HexabitzPlatform/H2AR3x-Hardware/README.md

# H2AR3x-Hardware
Hexabitz AC Current and Voltage Sensor Module Hardware Design
