HexabitzPlatform/H2AR3x-Hardware/H2AR32/Release/BOM/H2AR32.xlsx

 |  | www.hexabitz.com info@hexabitz.com |  | Bill Of Materials
Customer | Hexabitz | Revision | 2
Project | Hexabitz Modules | Date | 2023-09-26
Board | AC Current and Voltage Sensor Module (H2AR32) | Notes
Designator | Description | Manufacturer Part Number | Manufacturer | Octopart Url | Quantity
RESET | Headers & Wire Housings Unshrouded 1 POS T/H | 5-146280-1 | TE Connectivity | https://octopart.com/5-146280-1-te+connectivity+%2F+amp-40259676?r=sp | 1
SWD | Conn Unshrouded Header HDR 3 POS 2.54mm Solder ST Top Entry Thru-Hole Carton | 5-146281-3 | TE Connectivity | https://octopart.com/5-146281-3-te+connectivity+%2F+amp-39745942?r=sp | 1
CT , VIN | TERM BLOCK HEADER (5.08mm) Through Hole 2POS STR Male (Grey) | 1546111-2 | TE Connectivity | https://octopart.com/1546111-2-te+connectivity-40393355 | 2
R2 | RES SMD 0.0OHM JUMPER 1/10W 0603 | RC0603JR-070RL | YAGEO | https://octopart.com/rc0603jr-070rl-yageo-1241539?r=sp | 1
R6 | RES 0.1 OHM 0.1% 1W 2512 | Y14870R10000B9R | Vishay Precision Group | https://octopart.com/y14870r10000b9r-vishay+precision+group-20188347?r=sp | 1
R4, R5, R11, R12 | Thick Film Resistors - SMD 0603 1/10W 1.0 Ohm 1% Tol | CRCW06031R00FKEA | Vishay | https://octopart.com/crcw06031r00fkea-vishay-39713722?r=sp&s=biXSlGylTBiwPOCcABx_kA | 4
R14 | RES SMD 150 OHM 0,1% 1/4W 1206 | ERA-8AEB151V | Panasonic | https://octopart.com/era-8aeb151v-panasonic-55477439?r=sp | 1
R1 | Thick Film Resistors - SMD 0603 270 Ohm 5% Tol | ERJ-3GEYJ271V | Panasonic | https://octopart.com/erj-3geyj271v-panasonic-55560546?r=sp | 1
R7, R13 | RES 1K Ohm 5% 0603 | RC0603JR-071KL | Yageo | https://octopart.com/rc0603jr-071kl-yageo-55402888?r=sp | 2
R3 | RES 10K Ohm 5% 0603 | CRCW060310K0JNEB | Vishay | https://octopart.com/crcw060310k0jneb-vishay-46603269 | 1
R15 | RES 150K Ohm 1% 0603 | CRCW0603150KFKEA | Vishay | https://octopart.com/crcw0603150kfkea-vishay-39455816?r=sp | 1
R8, R9, R10,R16 | RES SMD 1M OHM 0,1% 1/4W 1206 | RT1206BRD071ML | YAGEO | https://octopart.com/rt1206brd071ml-yageo-1262221?r=sp | 4
C3, C5, C6, C8, C13, C14, C15, C19, C20 , C21, C22, C23 | CAP CER 0.1 UF 10% X7R 0603 | C0603C104K8RACTU | KEMET | https://octopart.com/c0603c104k8ractu-kemet-145075?r=sp&s=9bS9ASSwSEqMCE9KBEQZ0g | 12
C11, C12, C17, C18 | CAP CER 1UF 10V X5R 0603 | GRM188R61A105KA61J | Murata | https://octopart.com/grm188r61a105ka61j-murata-9221870?r=sp&s=wvtiDxTpS1CkWsFaa2pliQ | 4
C1,C2,C9 | CAP CER 1 UF 16V X7R 0805 | CC0805KKX7R7BB105 | YAGEO | https://octopart.com/cc0805kkx7r7bb105-yageo-8376555?r=sp | 3
C4, C7, C24 | CAP TANT 4.7 UF 10V 20% 0805 | 10TPU4R7MSI | Panasonic | https://octopart.com/10tpu4r7msi-panasonic-29487748?r=sp | 3
C10 , C16 | CAP CER 10UF 10V X5R 0603 | GRM188R61A106KE69D | Murata | https://octopart.com/grm188r61a106ke69d-murata-22851381?r=ap&s=o9t4ILLiSny6rfdd0oM5Kg | 2
FB1 | Ind chip Bead Multi-Layer 30 ohms 25% 100MHZ Ferrite 1,5A 0603Punched paper T/R | MMZ1608Y300BTA00 | TDK | https://octopart.com/mmz1608y300bta00-tdk-7906990?r=sp | 1
FB2, FB3, FB4, FB5 | 21 Ohms @ 100 MHz 1 Power Line Ferrite Bead 0805 (2012 Metric) 6A 4mOhm | FBMJ2125HM210NT | Taiyo Yuden | https://octopart.com/fbmj2125hm210nt-taiyo+yuden-368424?r=sp | 4
D1 | Red 0603 130° Clear 54 mcd 2 V Surface Mount ChipLED | VLMS1300-GS08 | Vishay | https://octopart.com/vlms1300-gs08-vishay-21709201?r=sp&s=0nXJNjGsSbWwqfqWlZv0EA | 1
D2, D3 | TVS DIODE 3,3V 10,9V SOD323 | CDSOD323-T03SC | Bourns | https://octopart.com/cdsod323-t03sc-bourns-10487153?r=sp | 2
U1 | MCU 32-Bit ARM Cortex-M0+ RISC 512kByte Flash 1.7V to 3.6V 48-Pin UFQFPN Tray | STM32G0B1CEU6N | STMicroelectronics | https://octopart.com/stm32g0b1ceu6n-stmicroelectronics-116364672?r=sp | 1
U2 | 26V, bi-directional current sense amplifier 6-SC70 -40 to 125 | INA199B2DCKT | Texas Instruments | https://octopart.com/ina199b2dckt-texas+instruments-24258237?r=sp | 1
U3 | 26V, bi-directional current sense amplifier 6-SC70 -40 to 125 | INA199B1DCKT | Texas Instruments | https://octopart.com/ina199b1dckt-texas+instruments-24258235?r=sp | 1
U4 | 3-V Vref, low-drift, low-power, dual-output Vref & Vref/2 voltage reference 5-SOT-23 | REF2030AIDDCT | Texas Instruments | https://octopart.com/ref2030aiddct-texas+instruments-46921198?r=sp | 1
X1 | 8,0000MHZ 33pF SMD MURATA Resonators | CSTNE8M00G550000R0 | Murata | https://octopart.com/cstne8m00g550000r0-murata-91406934?r=sp | 1
CT1 | Curr Sense Xfmr 100A In-line | cr8450-1000 | CR Magnetics | https://octopart.com/cr8450-1000-cr+magnetics-19500880?r=sp | 1
CT2 | Curr Sense Xfmr 4A In-line | CR8401-1000-G | CR Magnetics | https://octopart.com/cr8401-1000-g-cr+magnetics-1366028?r=sp | optional
