HexabitzPlatform/H2AR3x-Hardware/H2AR32/Documentation/H2AR32.pdf

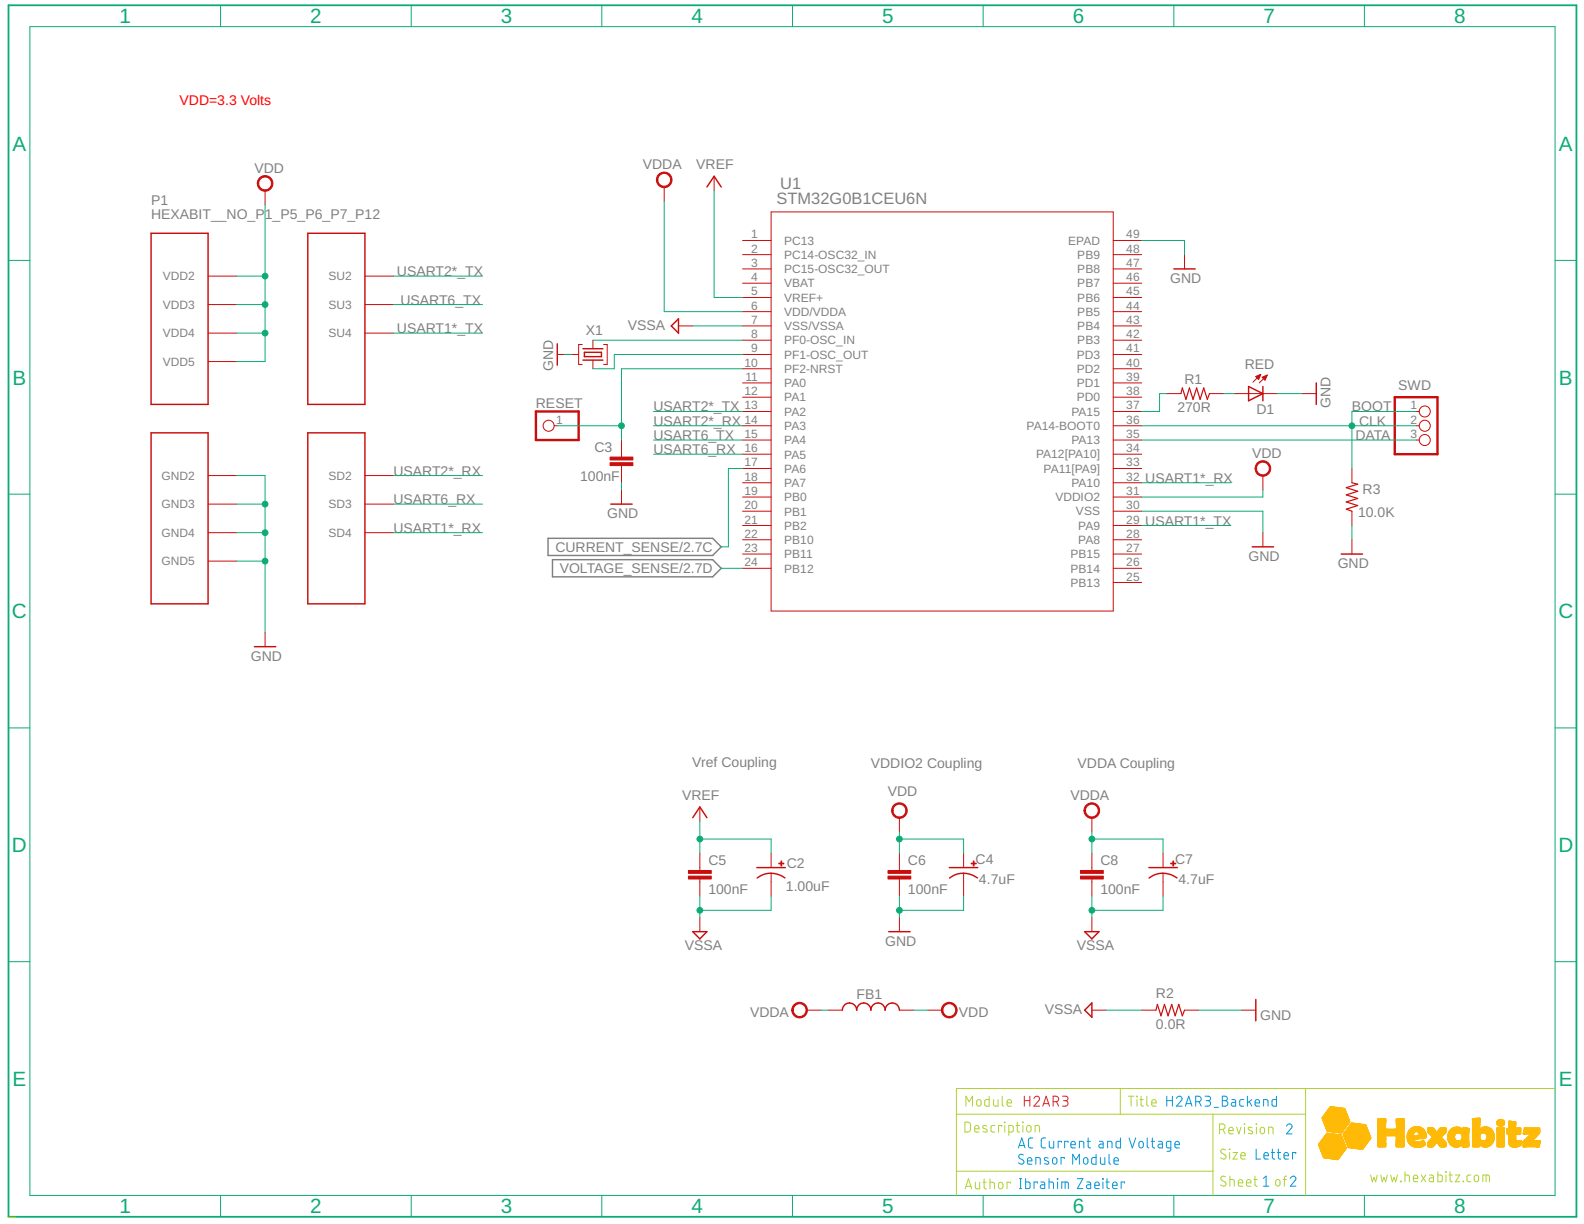
[picture p1: page 1]

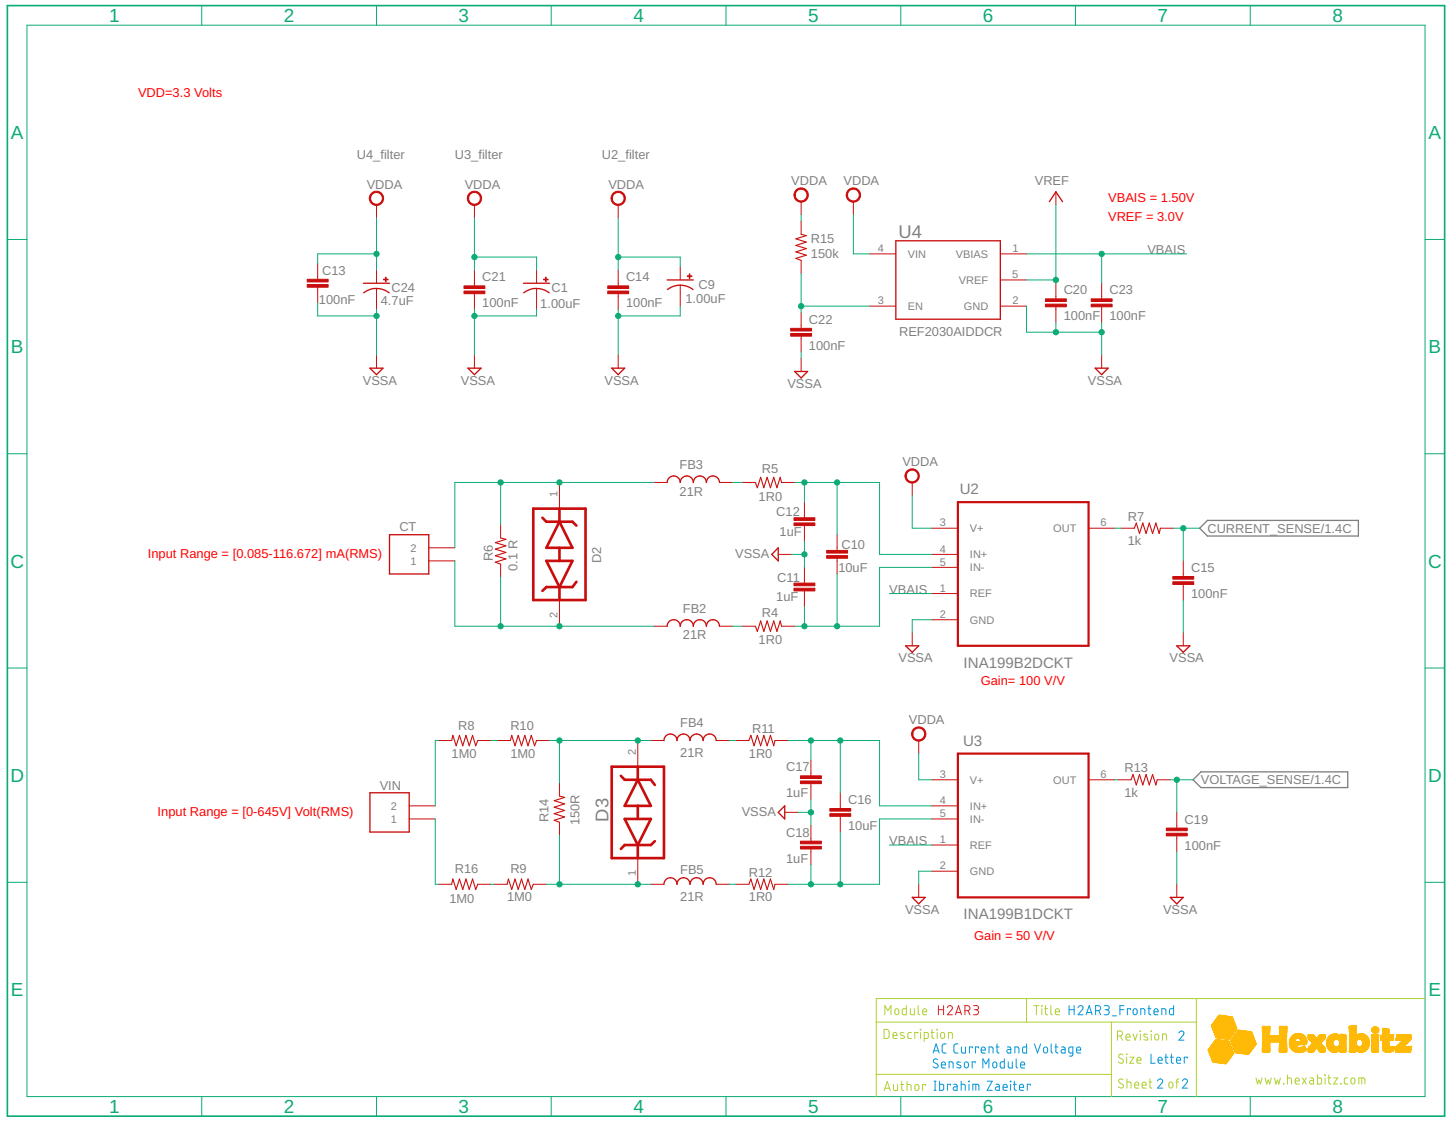
[picture p2: page 2]

Input Range = [0.085-116.672] mA(RMS)

Input Range = [0-645V] Volt(RMS)
