HexabitzPlatform/H2AR3x-Hardware/H2AR32/Design/H2AR32.brd

## EAGLE design H2AR32/Design/H2AR32.brd (2023-11-12)

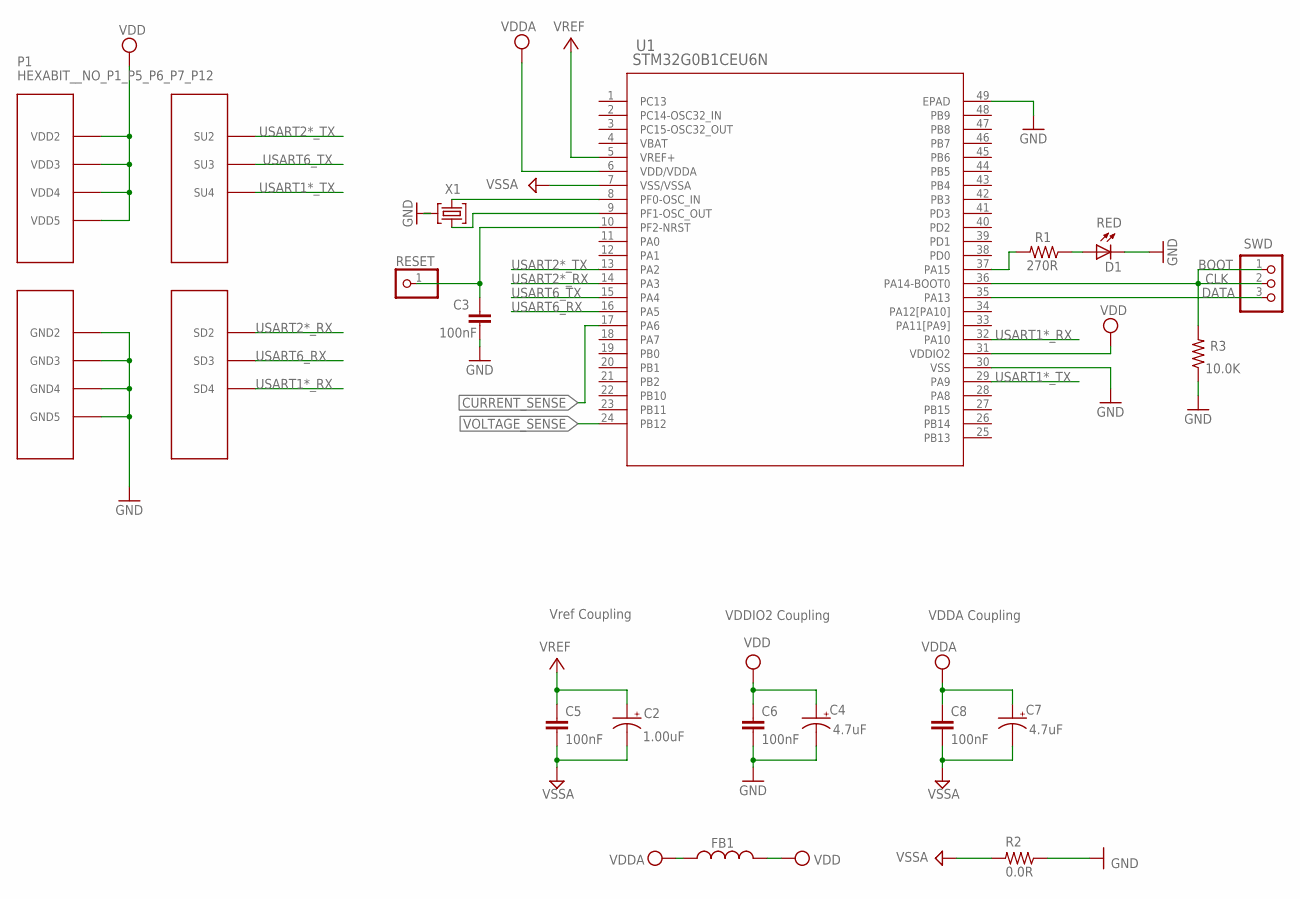
[picture p3: schematic H2AR32.sch, sheet 1]

Parts:
C2: 1.00uF; C-0805-POL; TOLERANCE 10%; VOLTAGE_RATING 16V; MPN CC0805KKX7R7BB105
C3, C5, C6: 100nF; C-0603; TOLERANCE 10%; VOLTAGE_RATING 10V; MPN C0603C104K8RACTU
C4, C7: 4.7uF; C-0805-POL; TOLERANCE 10%; VOLTAGE_RATING 25V; MPN GRM21BC81E475KA12L
C8: 100nF; C-0603; TOLERANCE 10%; VOLTAGE_RATING 10; MPN C0603C104K8RACTU
D1: RED; VLMS1300-GS08; MPN VLMS1300-GS08
FB1: FB-TDK_MMZ1608Y300B; MPN MMZ1608Y300B
P1: HEXABIT__NO_P1_P5_P6_P7_P12; HEXABIT_17.32_NO_P1_P6_P5_P7_P12
R1: 270R; R-0603; TOLERANCE 5%; MPN RC0603FR-07270RL
R2: 0.0R; R-0603; MPN RC0603JR-070RL
R3: 10.0K; R-0603; TOLERANCE 5%; MPN RC0603JR-0710KL
RESET: R; 1X01
SWD: PINHD-1X3; 1X03
U1: STM32G0B1CEU6N; HEXABITZ_ICS_QFN_B1CEU6_STM-L
X1: XTALL_CSTCE8M00G52

Connections:
CLK: R3.2, SWD.1, SWD.2, U1.36 (PA14-BOOT0)
CURRENT_SENSE: U1.17 (PA6); also elsewhere on the board
DATA: SWD.3, U1.35 (PA13)
GND: C3.2, C4.2 (-), C6.2, D1.C, P1.PAD_PD8 (GND2), P1.PAD_PD9 (GND3), P1.PAD_PD10 (GND4), P1.PAD_PD11 (GND5), R2.1, R3.1, U1.30 (VSS), U1.49 (EPAD), X1.P$2 (2)
unnamed: R1.2, U1.37 (PA15)
unnamed: D1.A, R1.1
unnamed: U1.8 (PF0-OSC_IN), X1.P$1 (1)
unnamed: U1.9 (PF1-OSC_OUT), X1.P$3 (3)
unnamed: C3.1, RESET.1, U1.10 (PF2-NRST)
USART1*_RX: P1.PAD_PD4 (SD4), U1.32 (PA10)
USART1*_TX: P1.PAD_PU4 (SU4), U1.29 (PA9)
USART2*_RX: P1.PAD_PD2 (SD2), U1.14 (PA3)
USART2*_TX: P1.PAD_PU2 (SU2), U1.13 (PA2)
USART6_RX: P1.PAD_PD3 (SD3), U1.16 (PA5)
USART6_TX: P1.PAD_PU3 (SU3), U1.15 (PA4)
VBAT: U1.4 (VBAT)
VDD: C4.1 (+), C6.1, FB1.2, P1.PAD_PU8 (VDD2), P1.PAD_PU9 (VDD3), P1.PAD_PU10 (VDD4), P1.PAD_PU11 (VDD5), U1.31 (VDDIO2)
VDDA: C7.1 (+), C8.1, FB1.1, U1.6 (VDD/VDDA); also elsewhere on the board
VOLTAGE_SENSE: U1.24 (PB12); also elsewhere on the board
VREF: C2.1 (+), C5.1, U1.5 (VREF+); also elsewhere on the board
VSSA: C2.2 (-), C5.2, C7.2 (-), C8.2, R2.2, U1.7 (VSS/VSSA); also elsewhere on the board

Notes on the sheet:
VDDA Coupling
VDDIO2 Coupling
BOOT
Vref Coupling

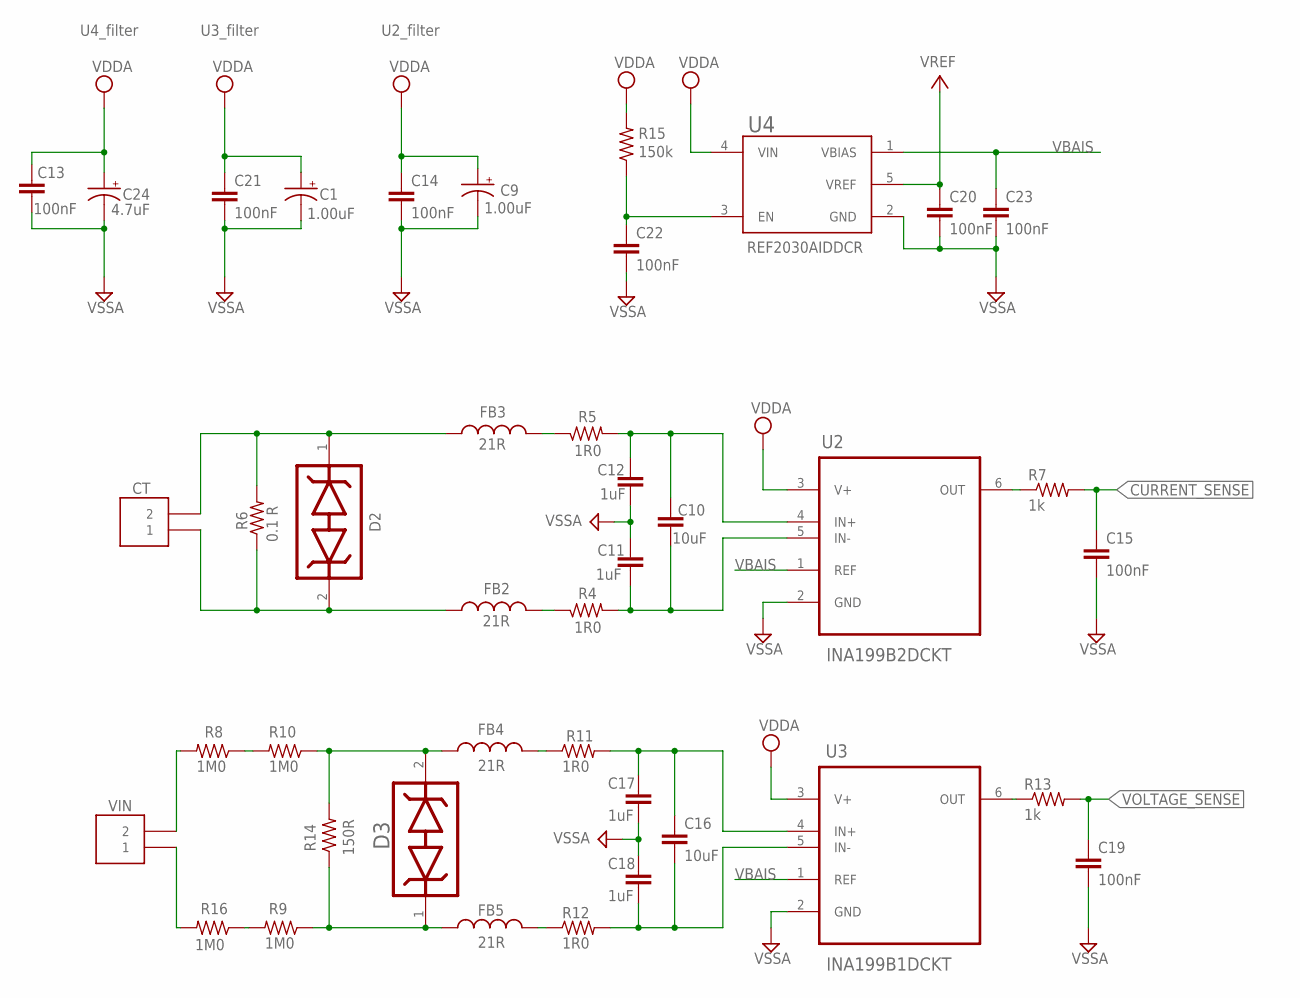
[picture p4: schematic H2AR32.sch, sheet 2]

Parts:
C1, C9: 1.00uF; C-0805-POL; TOLERANCE 10%; VOLTAGE_RATING 16V; MPN CC0805KKX7R7BB105
C10: 10uF; C-0603; VOLTAGE_RATING 6.3v; MPN C0603C106M9PACTU
C11, C12, C17, C18: 1uF; C-0603; TOLERANCE 10%; VOLTAGE_RATING 10v; MPN C0603C105K8RACTU
C13, C14, C15, C19, C20, C21, C22, C23: 100nF; C-0603; TOLERANCE 10%; VOLTAGE_RATING 10V; MPN C0603C104K8RACTU
C16: 10uF; C-0603; TOLERANCE 20%; VOLTAGE_RATING 6.3V; MPN C0603C106M9PACTU
C24: 4.7uF; C-0805-POL; TOLERANCE 10%; VOLTAGE_RATING 25V; MPN GRM21BC81E475KA12L
CT: 1546111-2
D2, D3: BOURNS_CDSOD323-T03SCBOURNS_CDSOD323-T03SC_0_0; BOURNS_CDSOD323-T03SC_0
FB2, FB3, FB4, FB5: 21R; FB-0805; MPN FBMJ2125HM210NT
R4, R5, R11, R12: 1R0; R-0603; TOLERANCE 1%; MPN CRCW06031R00FKEA
R6: 0.1 R; R2512
R7, R13: 1k; R-0603; TOLERANCE 5%; MPN RC0603JR-071KL
R8, R9, R10, R16: 1M0; R1206; MPN RT1206BRD071ML
R14: 150R; R1206; MPN ERA-8AEB151V
R15: 150k; R-0603; TOLERANCE 1%; MPN CRCW0603150KFKEA
U2: INA199B2DCKT; SOT65P210X110-6N
U3: INA199B1DCKT; SOT65P210X110-6N
U4: TEXAS_INSTRUMENTS_REF2033AIDDCRTEXAS_INSTRUMENTS_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; TEXAS_INSTRUMENTS_REF2033AIDDCR_2; MPN REF2030AIDDCR
VIN: 1546111-2

Connections:
CT_3: CT.1, D2.2, FB2.2, R6.1
CT_4: CT.2, D2.1, FB3.2, R6.2
CURRENT_SENSE: C15.1, R7.2; also elsewhere on the board
unnamed: C10.1, C11.2, R4.2, U2.5 (IN-)
unnamed: FB2.1, R4.1
unnamed: C10.2, C12.1, R5.2, U2.4 (IN+)
unnamed: FB3.1, R5.1
unnamed: R9.2, R16.1
unnamed: R8.2, VIN.2
unnamed: R8.1, R10.2
unnamed: R16.2, VIN.1
unnamed: R7.1, U2.6 (OUT)
unnamed: C22.1, R15.1, U4.3 (EN)
unnamed: C16.1, C17.2, R11.2, U3.4 (IN+)
unnamed: C16.2, C18.1, R12.2, U3.5 (IN-)
unnamed: FB4.2, R11.1
unnamed: FB5.2, R12.1
unnamed: D3.2, FB4.1, R10.1, R14.2
unnamed: D3.1, FB5.1, R9.1, R14.1
unnamed: R13.1, U3.6 (OUT)
VBAIS: C23.1, U2.1 (REF), U3.1 (REF), U4.1 (VBIAS)
VDDA: C1.1 (+), C9.1 (+), C13.1, C14.1, C21.1, C24.1 (+), R15.2, U2.3 (V+), U3.3 (V+), U4.4 (VIN); also elsewhere on the board
VOLTAGE_SENSE: C19.1, R13.2; also elsewhere on the board
VREF: C20.1, U4.5 (VREF); also elsewhere on the board
VSSA: C1.2 (-), C9.2 (-), C11.1, C12.2, C13.2, C14.2, C15.2, C17.1, C18.2, C19.2, C20.2, C21.2, C22.2, C23.2, C24.2 (-), U2.2 (GND), U3.2 (GND), U4.2 (GND); also elsewhere on the board

Notes on the sheet:
U2_filter
U3_filter
U4_filter

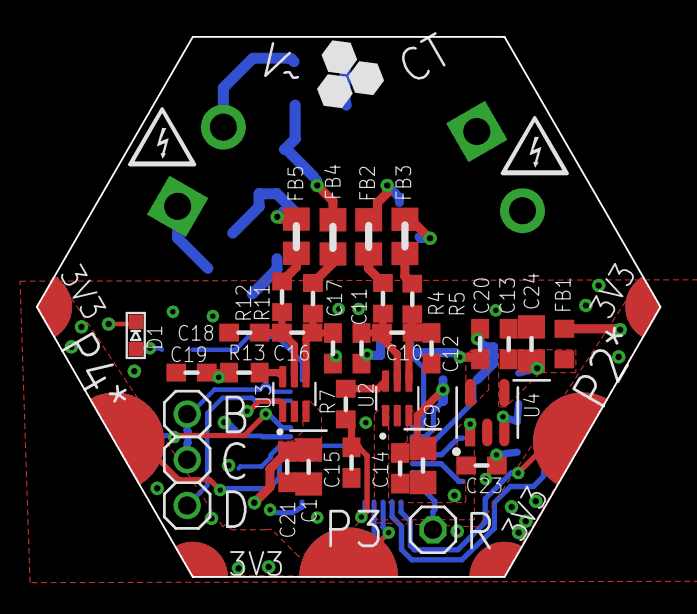
[picture p5: board H2AR32.brd from above]

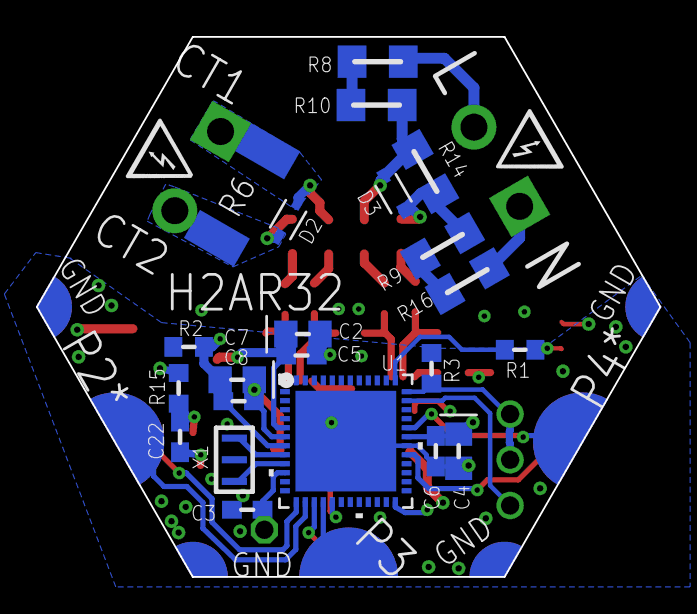
[picture p6: board H2AR32.brd from below]

Board: 4 copper layers, 34.6 x 30.0 mm, 58 parts (22 on the bottom side), 40 nets.
