HexabitzPlatform/H2AR3x-Hardware/(commit log)

2020-05-26 finish schematic Un-checked attributes not finished
    [H2AR30.brd, H2AR30.sch]
2020-05-27 some bugs fixed
    [H2AR30.brd, H2AR30.sch]
2020-05-28 some fixes
    [H2AR30.brd, H2AR30.sch]
2020-06-06 finished BOM
    [H2AR30.xlsx]
2020-06-12 Final Design: High voltage logos were added High voltage clearance checked * were added to boot pins 100A & 4A (optional ) CTs were added to BOM ERC & DRC were made
    [H2AR30.brd, H2AR30.sch, H2AR30.xlsx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]
2020-06-19 re-order the ports
    [H2AR30.brd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]
2021-04-19 final with double check
    [H2AR30.brd, H2AR30.sch, H2AR30.xlsx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]
2021-04-19 rev1 change
    [H2AR30.brd, H2AR30.sch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]
2023-09-26 -Changing the MCU to stm32g0b1ceu6n -Improving the layout design for better performance -Adding extra capacitors to the amplifiers supply
    [H2AR30.brd, H2AR30.sch, H2AR30.xlsx, H2AR32.brd, H2AR32.sch, H2AR32.xlsx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]
2023-09-26 -Update BOM
    [H2AR32.xlsx]
2023-11-12 -Update the pcb layout design to be based on 4 layers for better performance and improve the analog design
    [H2AR32.brd, H2AR32.sch, H2AR32.xlsx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]
